miakadam/Wk_Chip_Odyssey/docs/screenshots/c_dac1_switch.png

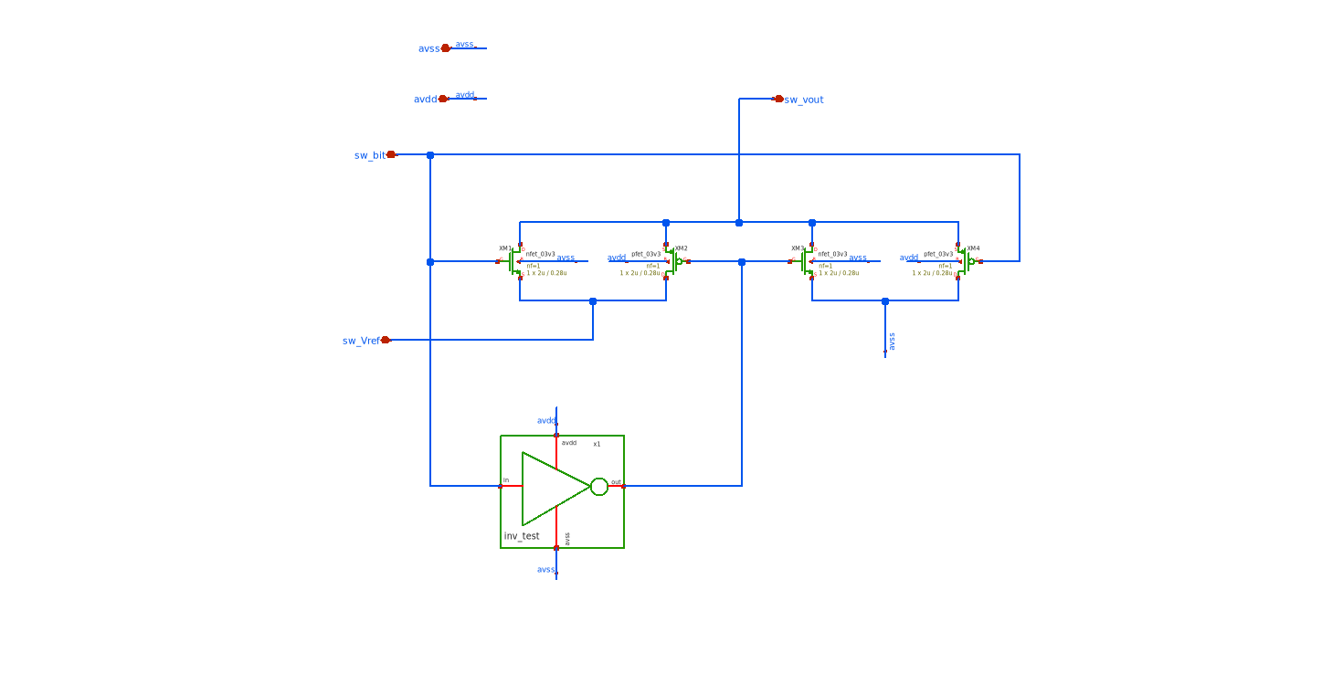
docs/screenshots/c_dac1_switch.png
