miakadam/Wk_Chip_Odyssey/docs/screenshots/c_dac_v1.png

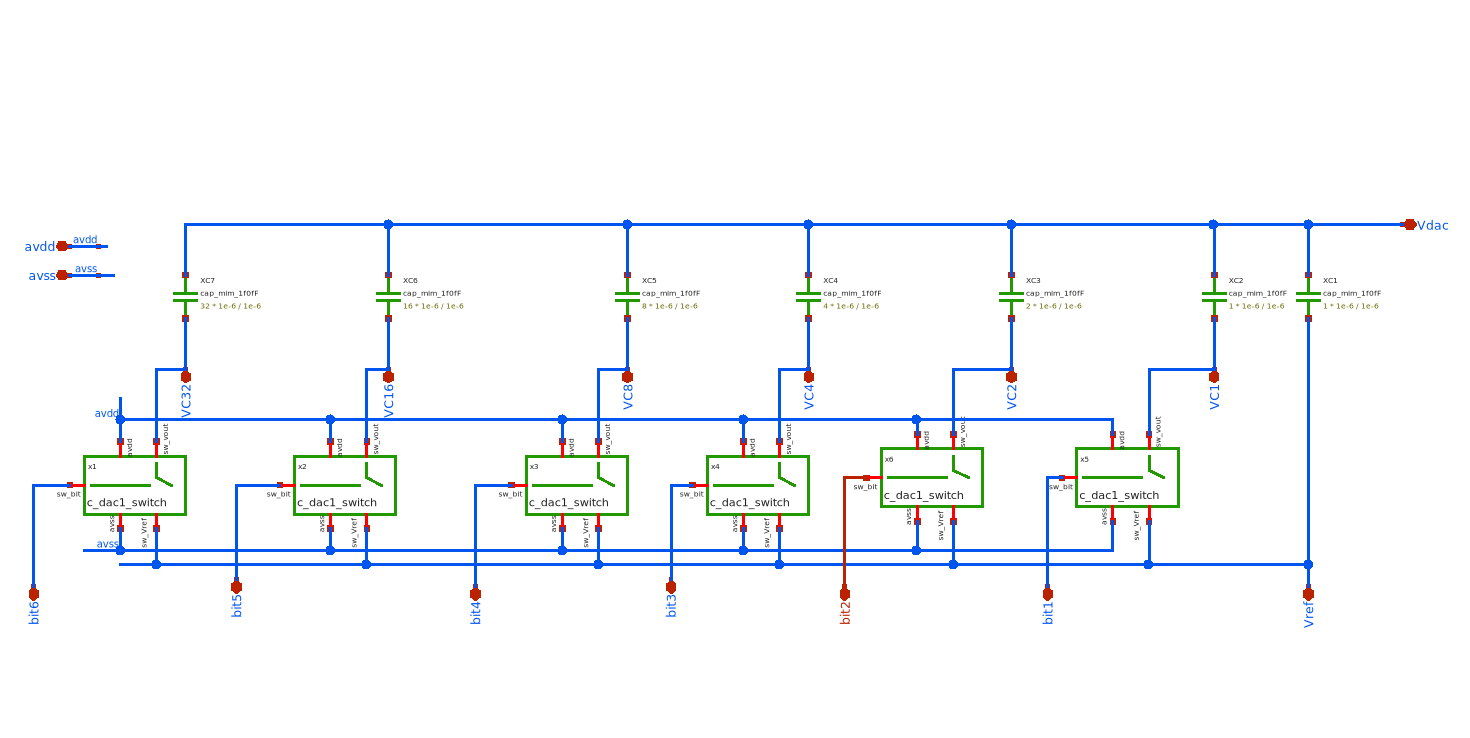
docs/screenshots/c_dac_v1.png
