miakadam/Wk_Chip_Odyssey/designs/FinalBlocksLayout/comparator/comparator_no_offsetcal.spice

* NGSPICE file created from comparator_no_offsetcal.ext - technology: (null)

.subckt comparator_no_offsetcal VDD VSS CLK Vin1 Vin2 Vout
X0 VDD.t41 a_5265_2223 Vout.t0 VDD.t40 pfet_03v3
**devattr s=18700,450 d=18700,450
X1 VDD.t43 a_6467_n692 a_6379_n600 VDD.t42 pfet_03v3
**devattr s=17600,576 d=10400,304
X2 lvsclean_SAlatch_0.Vout1.t6 lvsclean_SAlatch_0.Vout2.t9 lvsclean_SAlatch_0.Vp.t0 VSS.t4 nfet_03v3
**devattr s=20800,504 d=20800,504
X3 VSS.t23 a_7711_n4982 a_7623_n4890 VSS.t22 nfet_03v3
**devattr s=14080,496 d=8320,264
X4 VDD.t39 a_5265_2223 Vout.t1 VDD.t38 pfet_03v3
**devattr s=18700,450 d=18700,450
X5 VDD.t31 lvsclean_SAlatch_0.Vout2.t10 x5.out VDD.t30 pfet_03v3
**devattr s=70400,1776 d=70400,1776
X6 lvsclean_SAlatch_0.Vp.t15 CLK.t0 VDD.t7 VDD.t6 pfet_03v3
**devattr s=14080,496 d=14080,496
X7 a_9403_n600 a_9203_n692 VDD.t1 VDD.t0 pfet_03v3
**devattr s=10400,304 d=17600,576
X8 VDD.t3 CLK.t1 lvsclean_SAlatch_0.Vout2.t0 VDD.t2 pfet_03v3
**devattr s=14080,496 d=14080,496
X9 lvsclean_SAlatch_0.Vout2.t1 a_8125_n1848 a_8037_n1756 VSS.t19 nfet_03v3
**devattr s=35200,976 d=20800,504
X10 lvsclean_SAlatch_0.Vq Vin2.t0 a_6667_n4104.t20 VSS.t13 nfet_03v3
**devattr s=15600,404 d=15600,404
X11 a_6667_n4104.t10 Vin1.t0 lvsclean_SAlatch_0.Vp.t14 VSS.t17 nfet_03v3
**devattr s=15600,404 d=15600,404
X12 VDD.t17 lvsclean_SAlatch_0.Vout1.t9 lvsclean_SAlatch_0.Vout2.t2 VDD.t16 pfet_03v3
**devattr s=10400,304 d=10400,304
X13 lvsclean_SAlatch_0.Vout2.t5 lvsclean_SAlatch_0.Vout1.t10 VDD.t21 VDD.t20 pfet_03v3
**devattr s=10400,304 d=10400,304
X14 lvsclean_SAlatch_0.Vp.t16 a_6163_n3233 a_6075_n3141 VSS.t18 nfet_03v3
**devattr s=26400,776 d=15600,404
X15 lvsclean_SAlatch_0.Vp.t6 Vin1.t1 a_6667_n4104.t2 VSS.t9 nfet_03v3
**devattr s=15600,404 d=15600,404
X16 a_6667_n4104.t19 Vin2.t1 lvsclean_SAlatch_0.Vq VSS.t6 nfet_03v3
**devattr s=15600,404 d=15600,404
X17 a_6667_n4104.t3 Vin1.t2 lvsclean_SAlatch_0.Vp.t7 VSS.t10 nfet_03v3
**devattr s=15600,404 d=15600,404
X18 a_9707_n4104 a_9507_n4196 lvsclean_SAlatch_0.Vp.t3 VSS.t5 nfet_03v3
**devattr s=15600,404 d=26400,776
X19 Vout.t5 a_5265_2223 VSS.t39 VSS.t38 nfet_03v3
**devattr s=9350,280 d=9350,280
X20 lvsclean_SAlatch_0.Vout1.t3 lvsclean_SAlatch_0.Vout2.t11 VDD.t33 VDD.t32 pfet_03v3
**devattr s=10400,304 d=10400,304
X21 VDD.t5 CLK.t2 lvsclean_SAlatch_0.Vq VDD.t4 pfet_03v3
**devattr s=14080,496 d=14080,496
X22 a_7745_n1756 a_7545_n1848 lvsclean_SAlatch_0.Vout1.t8 VSS.t24 nfet_03v3
**devattr s=20800,504 d=35200,976
X23 a_5265_2223 x4.A VSS.t26 VSS.t25 nfet_03v3
**devattr s=9350,280 d=17000,540
X24 lvsclean_SAlatch_0.Vq lvsclean_SAlatch_0.Vout1.t11 lvsclean_SAlatch_0.Vout2.t6 VSS.t31 nfet_03v3
**devattr s=20800,504 d=20800,504
X25 x4.A x2.Vout2 VDD.t45 VDD.t44 pfet_03v3
**devattr s=17600,576 d=17600,576
X26 x4.A x3.out VSS.t44 VSS.t43 nfet_03v3
**devattr s=17600,576 d=17600,576
X27 lvsclean_SAlatch_0.Vq a_6163_n4196 a_6075_n4104 VSS.t18 nfet_03v3
**devattr s=26400,776 d=15600,404
X28 lvsclean_SAlatch_0.Vout1.t2 lvsclean_SAlatch_0.Vout2.t12 VDD.t11 VDD.t10 pfet_03v3
**devattr s=10400,304 d=10400,304
X29 a_6667_n4104.t18 Vin2.t2 lvsclean_SAlatch_0.Vq VSS.t8 nfet_03v3
**devattr s=15600,404 d=15600,404
X30 a_6667_n4104.t17 Vin2.t3 lvsclean_SAlatch_0.Vq VSS.t10 nfet_03v3
**devattr s=15600,404 d=15600,404
X31 Vout.t2 a_5265_2223 VDD.t37 VDD.t36 pfet_03v3
**devattr s=18700,450 d=18700,450
X32 Vout.t4 a_5265_2223 VSS.t37 VSS.t36 nfet_03v3
**devattr s=17000,540 d=9350,280
X33 lvsclean_SAlatch_0.Vout1.t7 CLK.t3 VDD.t9 VDD.t8 pfet_03v3
**devattr s=14080,496 d=14080,496
X34 lvsclean_SAlatch_0.Vp.t4 Vin1.t3 a_6667_n4104.t0 VSS.t7 nfet_03v3
**devattr s=15600,404 d=15600,404
X35 lvsclean_SAlatch_0.Vq Vin2.t4 a_6667_n4104.t16 VSS.t12 nfet_03v3
**devattr s=15600,404 d=15600,404
X36 a_5265_2223 x4.A VDD.t25 VDD.t24 pfet_03v3
**devattr s=18700,450 d=34000,880
X37 VDD.t13 lvsclean_SAlatch_0.Vout2.t13 lvsclean_SAlatch_0.Vout1.t1 VDD.t12 pfet_03v3
**devattr s=10400,304 d=10400,304
X38 lvsclean_SAlatch_0.Vout2.t3 lvsclean_SAlatch_0.Vout1.t12 VDD.t19 VDD.t18 pfet_03v3
**devattr s=10400,304 d=10400,304
X39 lvsclean_SAlatch_0.Vp.t2 lvsclean_SAlatch_0.Vout2.t14 lvsclean_SAlatch_0.Vout1.t5 VSS.t3 nfet_03v3
**devattr s=20800,504 d=20800,504
X40 a_6667_n4104.t1 Vin1.t4 lvsclean_SAlatch_0.Vp.t5 VSS.t8 nfet_03v3
**devattr s=15600,404 d=15600,404
X41 Vout.t3 a_5265_2223 VDD.t35 VDD.t34 pfet_03v3
**devattr s=34000,880 d=18700,450
X42 lvsclean_SAlatch_0.Vq lvsclean_SAlatch_0.Vout1.t13 lvsclean_SAlatch_0.Vout2.t4 VSS.t30 nfet_03v3
**devattr s=20800,504 d=20800,504
X43 a_9541_n1756 a_9341_n1848 lvsclean_SAlatch_0.Vq VSS.t42 nfet_03v3
**devattr s=20800,504 d=35200,976
X44 lvsclean_SAlatch_0.Vq Vin2.t5 a_6667_n4104.t15 VSS.t7 nfet_03v3
**devattr s=15600,404 d=15600,404
X45 VDD.t23 x4.A x2.Vout2 VDD.t22 pfet_03v3
**devattr s=17600,576 d=17600,576
X46 VSS.t41 x5.out x2.Vout2 VSS.t40 nfet_03v3
**devattr s=17600,576 d=17600,576
X47 a_6667_n4104.t4 Vin1.t5 lvsclean_SAlatch_0.Vp.t8 VSS.t11 nfet_03v3
**devattr s=15600,404 d=15600,404
X48 lvsclean_SAlatch_0.Vp.t9 Vin1.t6 a_6667_n4104.t5 VSS.t12 nfet_03v3
**devattr s=15600,404 d=15600,404
X49 lvsclean_SAlatch_0.Vout1.t4 lvsclean_SAlatch_0.Vout2.t15 lvsclean_SAlatch_0.Vp.t1 VSS.t2 nfet_03v3
**devattr s=20800,504 d=20800,504
X50 lvsclean_SAlatch_0.Vq Vin2.t6 a_6667_n4104.t14 VSS.t14 nfet_03v3
**devattr s=15600,404 d=15600,404
X51 x3.out lvsclean_SAlatch_0.Vout1.t14 VSS.t29 VSS.t28 nfet_03v3
**devattr s=35200,976 d=35200,976
X52 lvsclean_SAlatch_0.Vp.t13 a_6329_n1848 a_6241_n1756 VSS.t16 nfet_03v3
**devattr s=35200,976 d=20800,504
X53 a_6667_n4104.t21 CLK.t4 VSS.t21 VSS.t20 nfet_03v3
**devattr s=8320,264 d=8320,264
X54 a_8159_n4890 a_8079_n4982 a_6667_n4104.t8 VSS.t15 nfet_03v3
**devattr s=8320,264 d=14080,496
X55 VSS.t35 a_5265_2223 Vout.t6 VSS.t34 nfet_03v3
**devattr s=9350,280 d=9350,280
X56 VSS.t1 lvsclean_SAlatch_0.Vout2.t16 x5.out VSS.t0 nfet_03v3
**devattr s=35200,976 d=35200,976
X57 x3.out lvsclean_SAlatch_0.Vout1.t15 VDD.t27 VDD.t26 pfet_03v3
**devattr s=70400,1776 d=70400,1776
X58 VDD.t15 lvsclean_SAlatch_0.Vout2.t17 lvsclean_SAlatch_0.Vout1.t0 VDD.t14 pfet_03v3
**devattr s=10400,304 d=10400,304
X59 lvsclean_SAlatch_0.Vout2.t7 lvsclean_SAlatch_0.Vout1.t16 lvsclean_SAlatch_0.Vq VSS.t27 nfet_03v3
**devattr s=20800,504 d=20800,504
X60 a_6667_n4104.t13 Vin2.t7 lvsclean_SAlatch_0.Vq VSS.t17 nfet_03v3
**devattr s=15600,404 d=15600,404
X61 a_6667_n4104.t12 Vin2.t8 lvsclean_SAlatch_0.Vq VSS.t11 nfet_03v3
**devattr s=15600,404 d=15600,404
X62 VSS.t33 a_5265_2223 Vout.t7 VSS.t32 nfet_03v3
**devattr s=9350,280 d=9350,280
X63 lvsclean_SAlatch_0.Vp.t10 Vin1.t7 a_6667_n4104.t6 VSS.t13 nfet_03v3
**devattr s=15600,404 d=15600,404
X64 lvsclean_SAlatch_0.Vp.t11 Vin1.t8 a_6667_n4104.t7 VSS.t14 nfet_03v3
**devattr s=15600,404 d=15600,404
X65 lvsclean_SAlatch_0.Vq Vin2.t9 a_6667_n4104.t11 VSS.t9 nfet_03v3
**devattr s=15600,404 d=15600,404
X66 a_6667_n4104.t9 Vin1.t9 lvsclean_SAlatch_0.Vp.t12 VSS.t6 nfet_03v3
**devattr s=15600,404 d=15600,404
X67 VDD.t29 lvsclean_SAlatch_0.Vout1.t17 lvsclean_SAlatch_0.Vout2.t8 VDD.t28 pfet_03v3
**devattr s=10400,304 d=10400,304
X68 a_9707_n3141 a_9507_n3233 lvsclean_SAlatch_0.Vq VSS.t5 nfet_03v3
**devattr s=15600,404 d=26400,776
R0 Vout.n5 Vout.n4 6.5435
R1 Vout.n2 Vout.n1 6.5435
R2 x4.Y Vout.n8 4.5005
R3 x4.Y Vout 2.44925
R4 Vout.n6 Vout.n3 2.17483
R5 Vout.n4 Vout.t7 2.03874
R6 Vout.n4 Vout.t5 2.03874
R7 Vout.n1 Vout.t6 2.03874
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
R477 Vin1.n4 Vin1.t2 11.5195
R478 Vin1.n1 Vin1.t3 11.5195
R479 Vin1.n0 Vin1.t9 11.5195
R480 Vin1.n1 Vin1.n0 4.00673
R481 Vin1 Vin1.n8 3.5169
R482 Vin1.n7 Vin1.n5 3.16619
R483 Vin1.n3 Vin1.n1 0.650658
R484 Vin1.n8 Vin1.n7 0.280193
R485 Vin1.n4 Vin1.n3 0.279681
R486 Vin1.n5 Vin1.n4 0.231705
.ends
