miakadam/Wk_Chip_Odyssey/designs/comparator/magic/inv.spice

** sch_path: /foss/designs/comparator/inv.sch
**.subckt inv vdd vi vo vss
*.iopin vdd
*.iopin vss
*.ipin vi
*.opin vo
XM1 vo vi vss vss nfet_03v3 L=0.28u W=0.4u nf=1 ad='int((nf+1)/2) * W/nf * 0.18u' as='int((nf+2)/2) * W/nf * 0.18u' pd='2*int((nf+1)/2) * (W/nf + 0.18u)'
+ ps='2*int((nf+2)/2) * (W/nf + 0.18u)' nrd='0.18u / W' nrs='0.18u / W' sa=0 sb=0 sd=0 m=1
XM2 vo vi vdd vdd pfet_03v3 L=0.28u W=1u nf=1 ad='int((nf+1)/2) * W/nf * 0.18u' as='int((nf+2)/2) * W/nf * 0.18u' pd='2*int((nf+1)/2) * (W/nf + 0.18u)'
+ ps='2*int((nf+2)/2) * (W/nf + 0.18u)' nrd='0.18u / W' nrs='0.18u / W' sa=0 sb=0 sd=0 m=1
**.ends
.end
