miakadam/Wk_Chip_Odyssey/designs/comparator/magic/rslatch.spice

** sch_path: /foss/designs/comparator/rslatch.sch
**.subckt rslatch VDD Vout1 Vout2 Vin1 Vin2 VSS
*.iopin VDD
*.iopin VSS
*.iopin Vin1
*.iopin Vin2
*.iopin Vout1
*.iopin Vout2
XM1 Vout1 Vin1 VSS VSS nfet_03v3 L=0.28u W=0.8u nf=1 ad='int((nf+1)/2) * W/nf * 0.18u' as='int((nf+2)/2) * W/nf * 0.18u' pd='2*int((nf+1)/2) * (W/nf + 0.18u)'
+ ps='2*int((nf+2)/2) * (W/nf + 0.18u)' nrd='0.18u / W' nrs='0.18u / W' sa=0 sb=0 sd=0 m=1
XM2 Vout2 Vin2 VSS VSS nfet_03v3 L=0.28u W=0.8u nf=1 ad='int((nf+1)/2) * W/nf * 0.18u' as='int((nf+2)/2) * W/nf * 0.18u' pd='2*int((nf+1)/2) * (W/nf + 0.18u)'
+ ps='2*int((nf+2)/2) * (W/nf + 0.18u)' nrd='0.18u / W' nrs='0.18u / W' sa=0 sb=0 sd=0 m=1
XM3 Vout1 Vout2 VDD VDD pfet_03v3 L=0.28u W=0.8u nf=1 ad='int((nf+1)/2) * W/nf * 0.18u' as='int((nf+2)/2) * W/nf * 0.18u' pd='2*int((nf+1)/2) * (W/nf + 0.18u)'
+ ps='2*int((nf+2)/2) * (W/nf + 0.18u)' nrd='0.18u / W' nrs='0.18u / W' sa=0 sb=0 sd=0 m=1
XM4 Vout2 Vout1 VDD VDD pfet_03v3 L=0.28u W=0.8u nf=1 ad='int((nf+1)/2) * W/nf * 0.18u' as='int((nf+2)/2) * W/nf * 0.18u' pd='2*int((nf+1)/2) * (W/nf + 0.18u)'
+ ps='2*int((nf+2)/2) * (W/nf + 0.18u)' nrd='0.18u / W' nrs='0.18u / W' sa=0 sb=0 sd=0 m=1
**.ends
.end
