miakadam/Wk_Chip_Odyssey/(commit log)

2025-08-03 fix paths comparator
    [inv_chain.sch, tb_fixed.sch]
2025-08-05 cleaned up comparator files and renaming
    [inv_chain.sch, poweramp.sch, tb_TIAinput.sch, tb_comparator.sch, tb_comparator_slowmo.sch, untitled.sch]
2025-08-08 added preamp designs for comparator and slight reorganizing for TIA and CDAC
    [2stage_opamp.sch, cmos_example.sch, preamp.sch, strongArmLatch.sch, tb_comparator_slowmo.sch, tb_inputnoise.sch, tb_opamp.sch, tb_preamp.sch]
2025-08-09 added a bunch of buffer standard cells
    [inv.sch, tb_speedtest.sch]
2025-08-12 finished comparator offset correction
    [SA_withoffsetcal.sch, tb_offsetcal.sch, tb_offsetcal_meas.sch]
2025-08-14 full ADC testbench setup and fixes in other files
    [full_comparator.sch, strongArmLatch.sch, tb_TIAinput.sch, tb_comp_SARlogic.sch, tb_toplevel.sch]
2025-08-14 tested comparator and SAR logic working together
    [tb_comp_SARlogic.sch]
2025-08-15 finished basic gds of comparator core
    [SA_withoffsetcal.sch]
2025-08-15 finished full ADC gds
2025-08-20 add sample and hold
2025-08-20 testing CDAC with sampling
    [tb_toplevel.sch]
2025-08-21 started offset SIPO circuit
2025-08-22 add sample and hold tb
2025-08-22 finished and tested SIPO and PISO circuits
2025-08-24 started PISO load input and layout testing
    [tb_toplevel.sch]
2025-08-24 full adc testing
    [tb_newtoplevel.sch, tb_toplevel.sch]
2025-08-25 issues with cdac integration in adc
    [tb_comp_SARlogic.sch, tb_newtoplevel.sch]
2025-08-26 troubleshooting adc integration issues
    [tb_newtoplevel.sch]
2025-08-28 fixed sar logic and cdac working together issue
    [TB_CDAC_SAR_MK_V1.sch, tb_newtoplevel.sch]
2025-09-01 lots of integration and full ADC testing
    [tb_comp_SARlogic.sch, tb_fullADC.sch, tb_newtoplevel.sch, untitled.sch]
2025-09-07 bunch of lvs testing and garbage files
    [SA_withoffsetcal.sch, asc_NAND.sch, diffpairtest.sch, full_comparator.sch, lvsclean_SAlatch.sch, nmos.sch, untitled.sch]
2025-09-09 cleaned up testing files and verified diffpair lvs
    [diffpairtest.sch, nmos.sch]
2025-09-10 almost done with SA_latch layout
    [diffpairtest.sch, lvsclean_SAlatch.sch]
2025-09-11 lots of basic digital building blocks drc and lvs clean and finished
    [gf180mcu_osu_sc_gp9t3v3__buf_2.sch, gf180mcu_osu_sc_gp9t3v3__mux2_1.sch, gf180mcu_osu_sc_gp9t3v3__nand2_1.sch, lvsclean_SAlatch.sch, nand3_1.sch, osu_sc_and2_1.sch, osu_sc_inv_1.sch, osu_sc_nand2_1.sch]
2025-09-12 cleaned up comparator and added padframe file
    [buffer2x.sch, full_comparator.sch, gf180mcu_osu_sc_gp9t3v3__buf_2.sch, gf180mcu_osu_sc_gp9t3v3__mux2_1.sch, inv_mia.sch, lvsclean_SAlatch.sch, nand3.sch, nand3_1.sch]
2025-09-14 finished dffrs pex sims
    [dffrs.sch, tb_dffrs.sch]
2025-09-14 started SARlogic
    [SAR_logic_tb.sch, SARlogic.sch, dffrs.sch, inv_mia.sch, nand3.sch, tb_dffrs.sch, tb_dffrs_nand.sch]
2025-09-14 finished SARlogic pex sims
    [SAR_logic_tb.sch, SARlogic.sch]
2025-09-16 finished all the pex sims of the basic digital building blocks
    [2inmux.sch, adc_PISO.sch, and2.sch, inv2.sch, nand2.sch, nor2.sch, or2.sch, tb_adc_PISO.sch]
2025-09-17 finished PISO pex sims
    [adc_PISO.sch, tb_adc_PISO.sch]
2025-09-19 finished the final pad connection and integration
    [SAR_logic_tb.sch, comp_SAR_final.sch, comparator_no_offsetcal.sch, no_offsetLatch.sch, tb_SAR_PISO.sch, tb_adc_PISO.sch, tb_comp_SAR.sch, tb_full_comparator.sch]
